SemuBot/semubot-electronics/Kaur-thesis-2025-servo-arm/README.md

# Kaur-thesis-2025-servo-arm
Each separate project folder contains a corresponding readme.
<br>
## Python UI
Instructions and code found in folder ```Servo-Controller-Python-UI```.<br>
Link to original repository: https://github.com/martinkaur/Servo-controller-python-lib.git
<br>
## Controller board firmware
Instructions and code found in folder ```Servo-Controller-Firmware```.<br>
Link to original repository: https://github.com/martinkaur/Servo-Arm-Driver.git
<br>
## Controller board Altium Designer project files
Files found in folder ```Servo-Controller-Altium-Designer-Project-Files```.<br>
Link to original repository: https://github.com/martinkaur/Servo-Arm-Controller-Design.git
