SemuBot/semubot-electronics/servo-arm/pdf/signal-and-supply.pdf

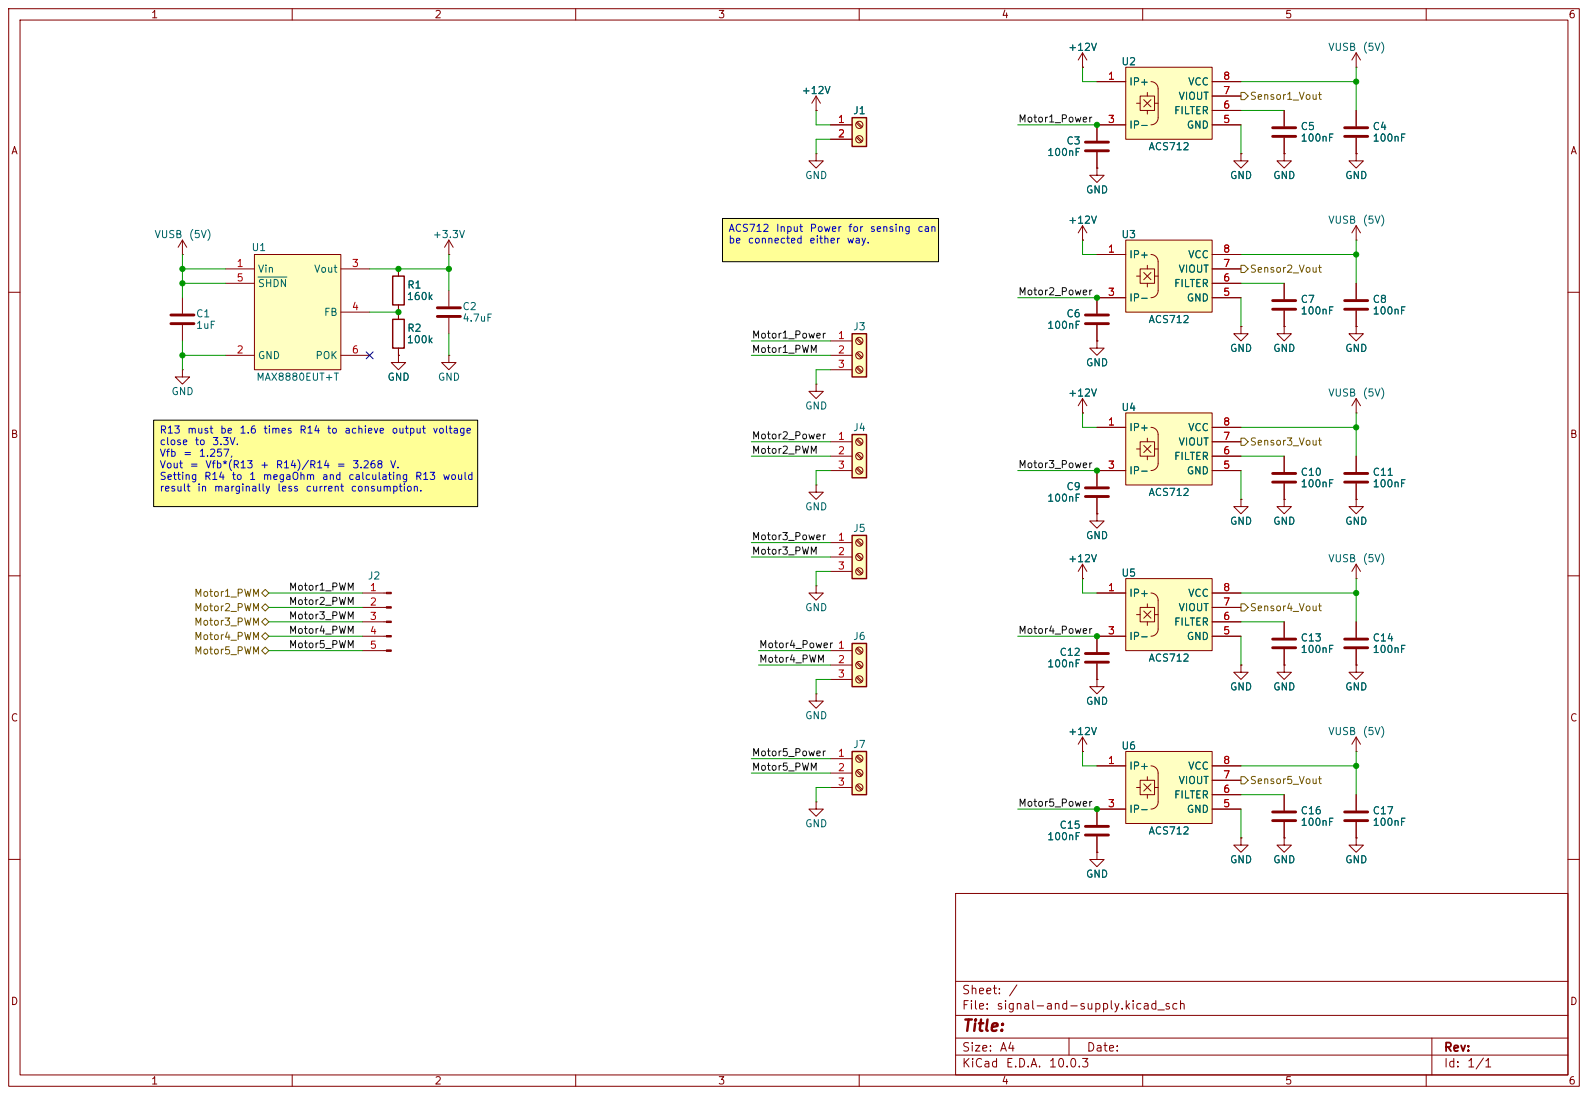
[picture p1: page 1]

be connected either way. +12V

close to 3.3V. Vfb = 1.257, Vout = Vfb*(R13 + R14)/R14 = 3.268 V. Setting R14 to 1 megaOhm and calculating R13 would

Sheet: /
File: signal-and-supply.kicad_sch
Title:

Size: A4 | Rev:
KiCad E.D.A. 10.0.3 | Id: 1/1
