SemuBot/semubot-electronics/(list of files, drawings)

Other design files:
Kaur-thesis-2025-servo-arm/Servo-Controller-Altium-Designer-Project-Files/Arm_controller.PcbDoc
Kaur-thesis-2025-servo-arm/Servo-Controller-Altium-Designer-Project-Files/MCU.SchDoc
Kaur-thesis-2025-servo-arm/Servo-Controller-Altium-Designer-Project-Files/Servo_arm_controller.PrjPcb
Kaur-thesis-2025-servo-arm/Servo-Controller-Altium-Designer-Project-Files/Signal_and_supply.SchDoc
powerboard/HotSwap.SchDoc
powerboard/PCB_S.PcbDoc
powerboard/VoltageDivision.SchDoc
