SemuBot/semubot-electronics/SemuBot_WheelBase/Wheelbase/Wheelbase.kicad_pcb

## KiCad design SemuBot_WheelBase/Wheelbase/Wheelbase.kicad_pcb (2026-09-03)

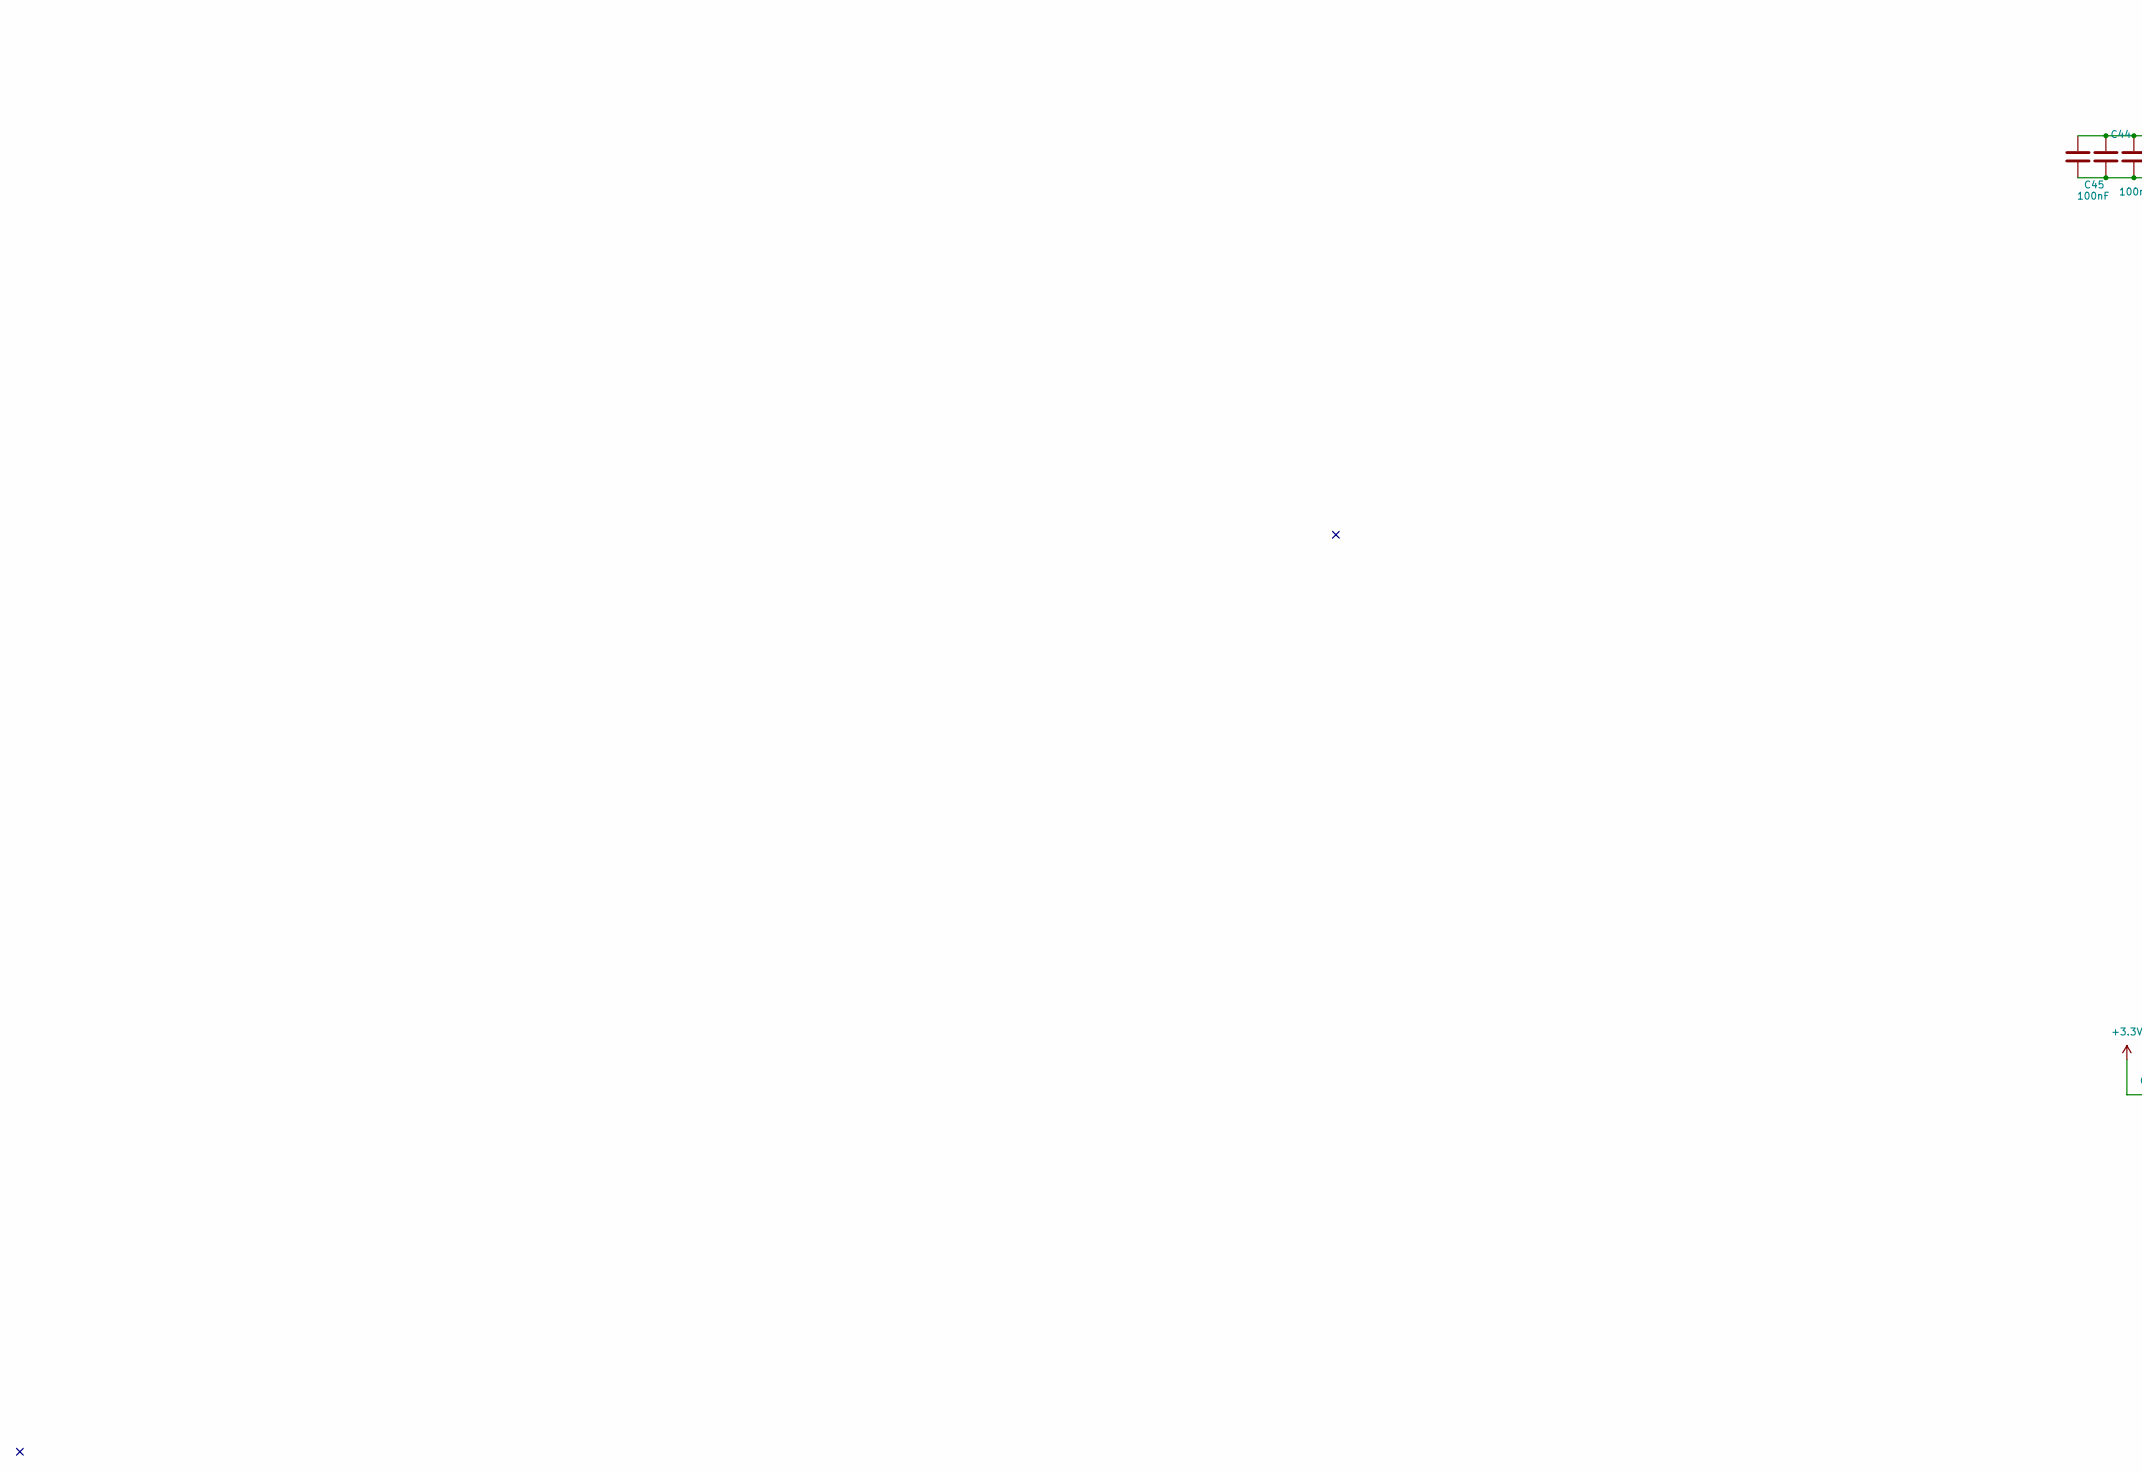
[picture p2: schematic Wheelbase.kicad_sch, part in row 1, column 1]

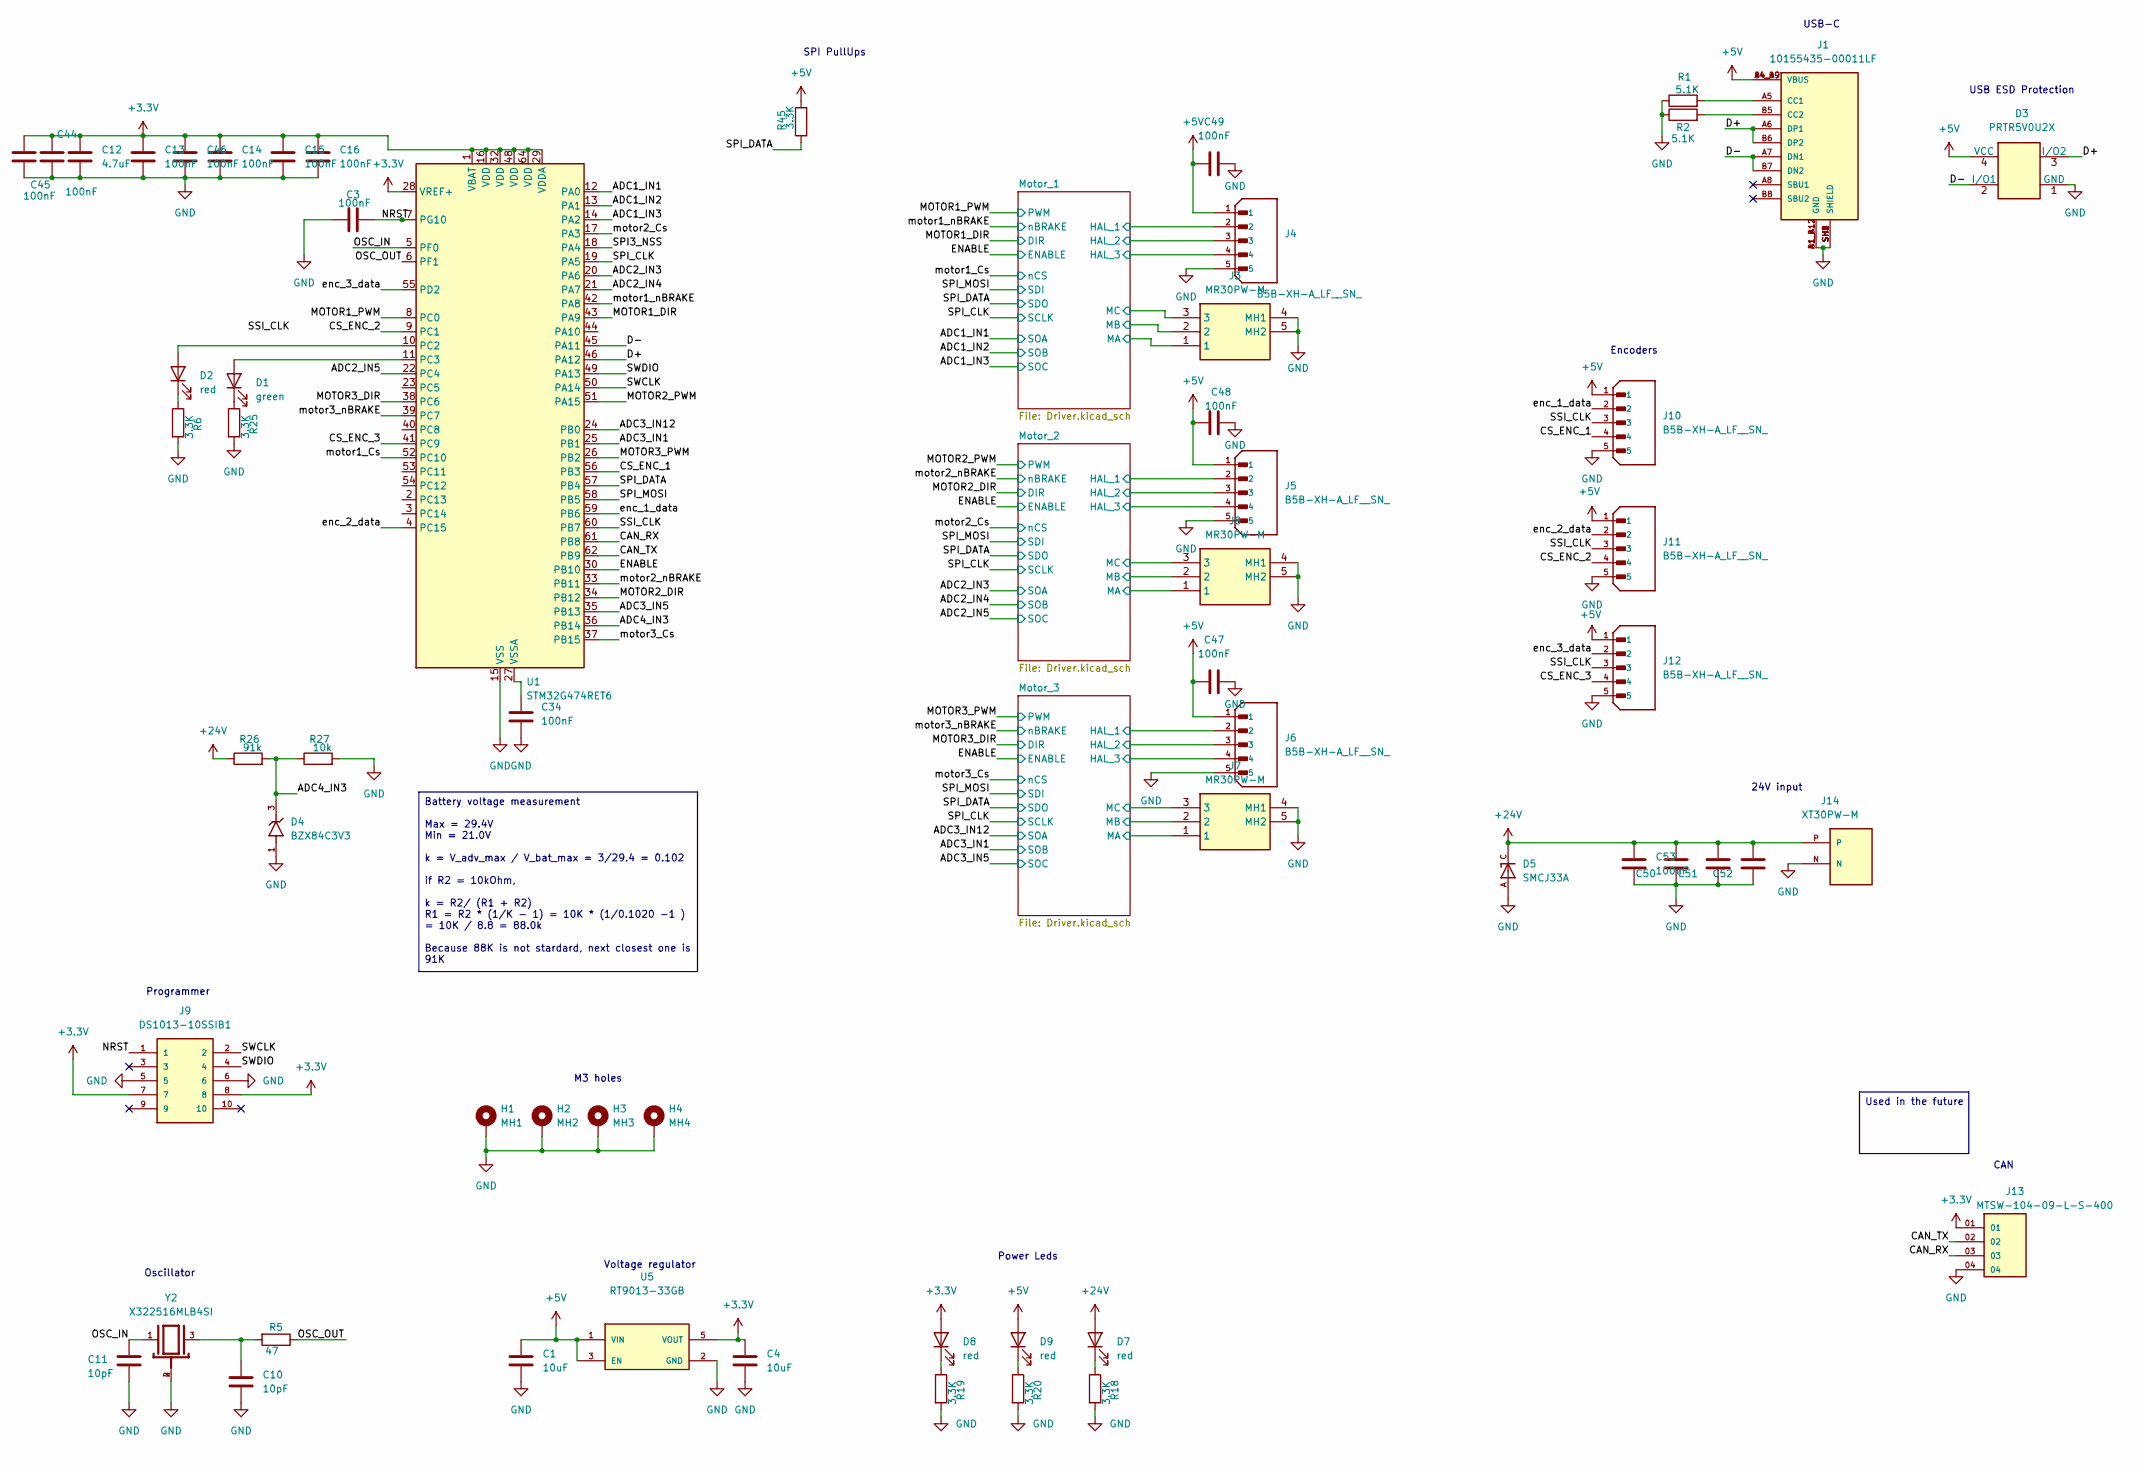
[picture p3: schematic Wheelbase.kicad_sch, part in row 1, column 2]

Parts:
C1, C4: 10uF; C_0805_2012Metric_Pad1.18x1.45mm_HandSolder
C3, C13, C14, C15, C16, C34, C44, C45, C46, C47, C48, C49, C53: 100nF; C_0603_1608Metric_Pad1.08x0.95mm_HandSolder
C10, C11: 10pF; C_0603_1608Metric_Pad1.08x0.95mm_HandSolder
C12: 4.7uF; C_0603_1608Metric_Pad1.08x0.95mm_HandSolder
C50, C51, C52: 470uF 5mm 63V Polymer; CP_Radial_D10.0mm_P5.00mm
D1: green; LED_0603_1608Metric_Pad1.05x0.95mm_HandSolder
D2, D7, D8, D9: red; LED_0603_1608Metric_Pad1.05x0.95mm_HandSolder
D3: PRTR5V0U2X; SOT-143
D4: BZX84C3V3; SOT95P240X115-3N; PARTREV 2025-02-06
D5: SMCJ33A; DIOM6859X262N; PARTREV R2102
H1: MH1; MountingHole_3.2mm_M3_Pad_Via
H2: MH2; MountingHole_3.2mm_M3_Pad_Via
H3: MH3; MountingHole_3.2mm_M3_Pad_Via
H4: MH4; MountingHole_3.2mm_M3_Pad_Via
J1: 10155435-00011LF; AMPHENOL_10155435-00011LF; PARTREV C
J3, J7, J8: MR30PW-M; MR30PWM; Manufacturer_Part_Number MR30PW-M
J4, J5, J6, J10, J11, J12: B5B-XH-A_LF__SN_; JST_B5B-XH-A_LF__SN_; PARTREV 7/4/21
J9: DS1013-10SSIB1; CONNFLY_DS1013-10SSIB1; PARTREV G
J13: MTSW-104-09-L-S-400; SAMTEC_MTSW-104-09-L-S-400; PARTREV R
J14: XT30PW-M; AMASS_XT30PW-M; PARTREV 1.2
R1, R2: 5.1K; R_0603_1608Metric_Pad0.98x0.95mm_HandSolder
R5: 47; R_0603_1608Metric_Pad0.98x0.95mm_HandSolder
R6, R18, R19, R20, R25, R45: 3.3K; R_0603_1608Metric_Pad0.98x0.95mm_HandSolder
R26: 91k; R_0603_1608Metric_Pad0.98x0.95mm_HandSolder
R27: 10k; R_0603_1608Metric_Pad0.98x0.95mm_HandSolder
U1: STM32G474RET6; LQFP-64_10x10mm_P0.5mm
U5: RT9013-33GB; SOT94P279X129-5N; PARTREV Aprill 2011
Y2: X322516MLB4SI; OSC_X322516MLB4SI; PARTREV N/A

Connections:
+3.3V: C4.2, C12.1, C13.1, C14.1, C15.1, C16.1, C44.1, C45.1, C46.1, D8.2 (A), J9.7, J9.8, J13.01, U1.1 (VBAT), U1.16 (VDD), U1.28 (VREF+), U1.29 (VDDA), U1.32 (VDD), U1.48 (VDD), U1.64 (VDD), U5.5 (VOUT); also elsewhere on the board
+5V: C1.2, C47.1, C48.1, C49.1, D3.4 (VCC), D9.2 (A), J1.A4_B9 (VBUS), J1.B4_A9 (VBUS), J4.1, J5.1, J6.1, J10.1, J11.1, J12.1, R45.2, U5.1 (VIN), U5.3 (EN); also elsewhere on the board
+24V: C50.2, C51.2, C52.2, C53.1, D5.C, D7.2 (A), J14.P, R26.1; also elsewhere on the board
/ADC1_IN1: U1.12 (PA0); also elsewhere on the board
/ADC1_IN2: U1.13 (PA1); also elsewhere on the board
/ADC1_IN3: U1.14 (PA2); also elsewhere on the board
/ADC2_IN3: U1.20 (PA6); also elsewhere on the board
/ADC2_IN4: U1.21 (PA7); also elsewhere on the board
/ADC2_IN5: U1.22 (PC4); also elsewhere on the board
/ADC3_IN1: U1.25 (PB1); also elsewhere on the board
/ADC3_IN5: U1.35 (PB13); also elsewhere on the board
/ADC3_IN12: U1.24 (PB0); also elsewhere on the board
/ADC4_IN3: D4.3, R26.2, R27.1, U1.36 (PB14)
/CAN_RX: J13.03, U1.61 (PB8)
/CAN_TX: J13.02, U1.62 (PB9)
/CS_ENC_1: J10.4, U1.56 (PB3)
/CS_ENC_2: J11.4, U1.9 (PC1)
/CS_ENC_3: J12.4, U1.41 (PC9)
/D+: D3.3 (I/O2), J1.A6 (DP1), J1.B6 (DP2), U1.46 (PA12)
/D-: D3.2 (I/O1), J1.A7 (DN1), J1.B7 (DN2), U1.45 (PA11)
/ENABLE: U1.30 (PB10); also elsewhere on the board
/MOTOR1_DIR: U1.43 (PA9); also elsewhere on the board
/MOTOR1_PWM: U1.8 (PC0); also elsewhere on the board
/MOTOR2_DIR: U1.34 (PB12); also elsewhere on the board
/MOTOR2_PWM: U1.51 (PA15); also elsewhere on the board
/MOTOR3_DIR: U1.38 (PC6); also elsewhere on the board
/MOTOR3_PWM: U1.26 (PB2); also elsewhere on the board
/Motor_1/HAL_1: J4.2; also elsewhere on the board
/Motor_1/HAL_2: J4.3; also elsewhere on the board
/Motor_1/HAL_3: J4.4; also elsewhere on the board
/Motor_1/SHA: J3.1; also elsewhere on the board
/Motor_1/SHB: J3.2; also elsewhere on the board
/Motor_1/SHC: J3.3; also elsewhere on the board
/Motor_2/HAL_1: J5.2; also elsewhere on the board
/Motor_2/HAL_2: J5.3; also elsewhere on the board
/Motor_2/HAL_3: J5.4; also elsewhere on the board
/Motor_2/SHA: J8.1; also elsewhere on the board
/Motor_2/SHB: J8.2; also elsewhere on the board
/Motor_2/SHC: J8.3; also elsewhere on the board
/Motor_3/HAL_1: J6.2; also elsewhere on the board
/Motor_3/HAL_2: J6.3; also elsewhere on the board
/Motor_3/HAL_3: J6.4; also elsewhere on the board
/Motor_3/SHA: J7.1; also elsewhere on the board
/Motor_3/SHB: J7.2; also elsewhere on the board
/Motor_3/SHC: J7.3; also elsewhere on the board
/NRST: C3.2, J9.1, U1.7 (PG10)
/OSC_IN: C11.1, U1.5 (PF0), Y2.1
/OSC_OUT: R5.1, U1.6 (PF1)
/SPI3_NSS: U1.18 (PA4)
/SPI_CLK: U1.19 (PA5); also elsewhere on the board
/SPI_DATA: R45.1, U1.57 (PB4); also elsewhere on the board
/SPI_MOSI: U1.58 (PB5); also elsewhere on the board
/SSI_CLK: J10.3, J11.3, J12.3, U1.60 (PB7)
/SWCLK: J9.2, U1.50 (PA14)
/SWDIO: J9.4, U1.49 (PA13)
/enc_1_data: J10.2, U1.59 (PB6)
/enc_2_data: J11.2, U1.4 (PC15)
/enc_3_data: J12.2, U1.55 (PD2)
/motor1_Cs: U1.52 (PC10); also elsewhere on the board
/motor1_nBRAKE: U1.42 (PA8); also elsewhere on the board
/motor2_Cs: U1.17 (PA3); also elsewhere on the board
/motor2_nBRAKE: U1.33 (PB11); also elsewhere on the board
/motor3_Cs: U1.37 (PB15); also elsewhere on the board
/motor3_nBRAKE: U1.39 (PC7); also elsewhere on the board
GND: C1.1, C3.1, C4.1, C10.1, C11.2, C12.2, C13.2, C14.2, C15.2, C16.2, C34.2, C44.2, C45.2, C46.2, C47.2, C48.2, C49.2, C50.1, C51.1, C52.1, C53.2, D3.1 (GND), D4.1, D5.A, H1.1 (1_1), H2.1 (1_1), H3.1 (1_1), H4.1 (1_1), J1.A1_B12 (GND), J1.B1_A12 (GND), J1.SH1 (SHIELD), J1.SH2 (SHIELD), J1.SH3 (SHIELD), J1.SH4 (SHIELD), J3.4 (MH1), J3.5 (MH2), J4.5, J5.5, J6.5, J7.4 (MH1), J7.5 (MH2), J8.4 (MH1), J8.5 (MH2), J9.5, J9.6, J10.5, J11.5, J12.5, J13.04, J14.N, R1.1, R2.1, R6.2, R18.2, R19.2, R20.2, R25.2, R27.2, U1.15 (VSS), U1.31 (VSS), U1.47 (VSS), U1.63 (VSS), U5.2 (GND), Y2.2, Y2.4; also elsewhere on the board
unnamed: C10.2, R5.2, Y2.3
unnamed: D1.2 (A), U1.11 (PC3)
unnamed: D1.1 (K), R25.1
unnamed: D2.2 (A), U1.10 (PC2)
unnamed: D2.1 (K), R6.1
unnamed: D7.1 (K), R18.1
unnamed: D8.1 (K), R19.1
unnamed: D9.1 (K), R20.1
unnamed: J1.A5 (CC1), R1.2
unnamed: J1.B5 (CC2), R2.2
unnamed: C34.1, U1.27 (VSSA)

Notes on the sheet:
24V input
Encoders
M3 holes
Oscillator
USB-C
USB ESD Protection
CAN
SPI PullUps
Power Leds
Programmer
Voltage regulator
Used in the future
Battery voltage measurement Max = 29.4V Min = 21.0V k = V_adv_max / V_bat_max = 3/29.4 = 0.102 if R2 = 10kOhm, k = R2/ (R1 + R2) R1 = R2 * (1/K - 1) = 10K * (1/0.1020 -1 ) = 10K / 8.8 = 88.0k Because 88K is not stardard, next closest one is 91K

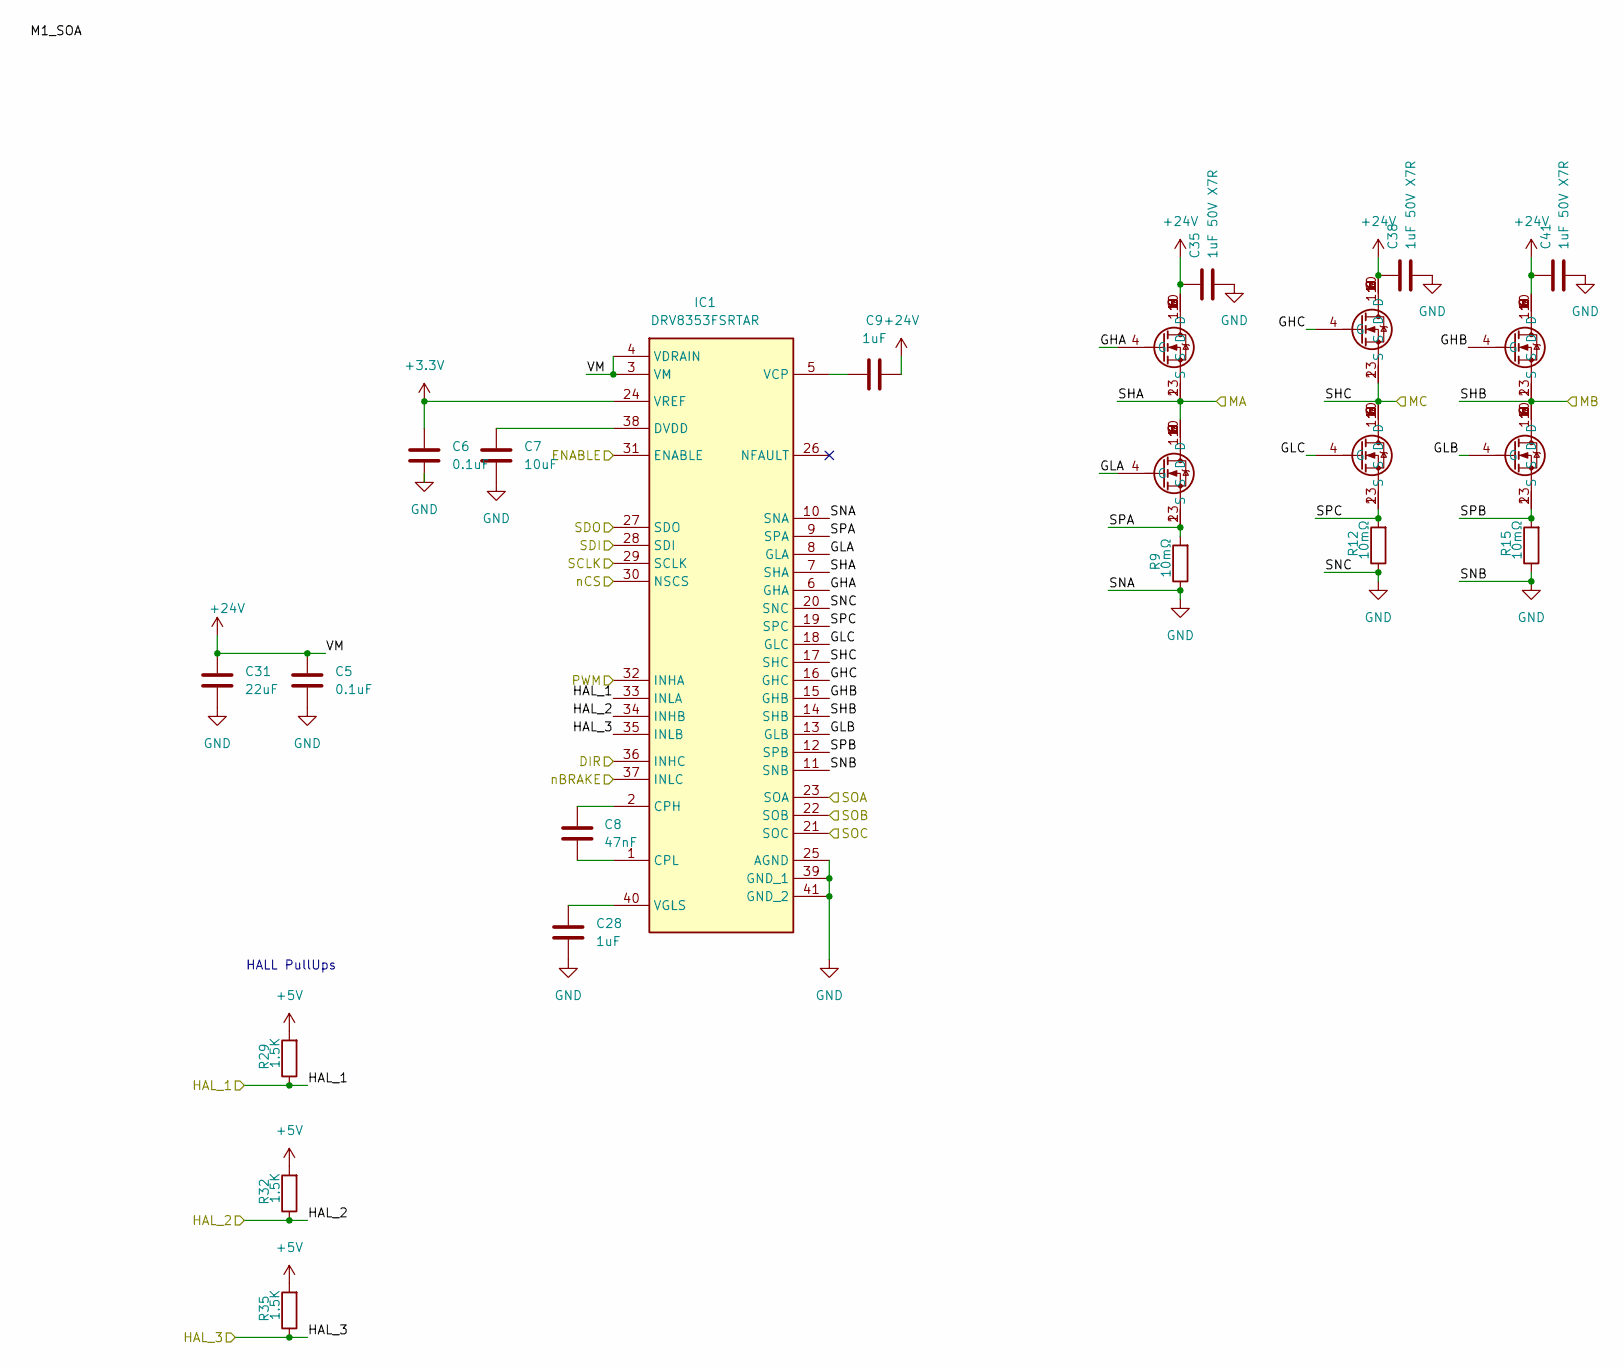
[picture p4: schematic Driver.kicad_sch]

Parts:
C5, C6: 0.1uF; C_0603_1608Metric_Pad1.08x0.95mm_HandSolder
C7: 10uF; C_0603_1608Metric_Pad1.08x0.95mm_HandSolder
C8: 47nF; C_0603_1608Metric_Pad1.08x0.95mm_HandSolder
C9, C28: 1uF; C_0603_1608Metric_Pad1.08x0.95mm_HandSolder
C31: 22uF; C_0805_2012Metric_Pad1.18x1.45mm_HandSolder
C35, C38, C41: 1uF 50V X7R; C_0805_2012Metric_Pad1.18x1.45mm_HandSolder
IC1: DRV8353FSRTAR; QFN50P600X600X80-41N-D; Mouser Part Number 595-DRV8353FSRTAR
Q1, Q2, Q3, Q5, Q6, Q19: AONR62818; AON7262E; Manufacturer_Part_Number AON7262E
R9, R12, R15: 10mΩ; R_2512_6332Metric_Pad1.40x3.35mm_HandSolder
R29, R32, R35: 1.5K; R_0603_1608Metric_Pad0.98x0.95mm_HandSolder

Connections:
+3.3V: C6.1, IC1.24 (VREF); also elsewhere on the board
+5V: R29.2, R32.2, R35.2; also elsewhere on the board
+24V: C5.1, C9.2, C31.2, C35.1, C38.1, C41.1, IC1.3 (VM), IC1.4 (VDRAIN), Q1.5 (D), Q1.6 (D), Q1.7 (D), Q1.8 (D), Q1.9 (D), Q1.10 (D), Q1.11 (D), Q3.5 (D), Q3.6 (D), Q3.7 (D), Q3.8 (D), Q3.9 (D), Q3.10 (D), Q3.11 (D), Q5.5 (D), Q5.6 (D), Q5.7 (D), Q5.8 (D), Q5.9 (D), Q5.10 (D), Q5.11 (D); also elsewhere on the board
/ADC1_IN1: IC1.23 (SOA); also elsewhere on the board
/ADC1_IN2: IC1.22 (SOB); also elsewhere on the board
/ADC1_IN3: IC1.21 (SOC); also elsewhere on the board
/ENABLE: IC1.31 (ENABLE); also elsewhere on the board
/MOTOR1_DIR: IC1.36 (INHC); also elsewhere on the board
/MOTOR1_PWM: IC1.32 (INHA); also elsewhere on the board
/Motor_1/GHA: IC1.6 (GHA), Q1.4 (G)
/Motor_1/GHB: IC1.15 (GHB), Q3.4 (G)
/Motor_1/GHC: IC1.16 (GHC), Q5.4 (G)
/Motor_1/GLA: IC1.8 (GLA), Q2.4 (G)
/Motor_1/GLB: IC1.13 (GLB), Q19.4 (G)
/Motor_1/GLC: IC1.18 (GLC), Q6.4 (G)
/Motor_1/HAL_1: IC1.33 (INLA), R29.1; also elsewhere on the board
/Motor_1/HAL_2: IC1.34 (INHB), R32.1; also elsewhere on the board
/Motor_1/HAL_3: IC1.35 (INLB), R35.1; also elsewhere on the board
/Motor_1/SHA: IC1.7 (SHA), Q1.1 (S), Q1.2 (S), Q1.3 (S), Q2.5 (D), Q2.6 (D), Q2.7 (D), Q2.8 (D), Q2.9 (D), Q2.10 (D), Q2.11 (D); also elsewhere on the board
/Motor_1/SHB: IC1.14 (SHB), Q3.1 (S), Q3.2 (S), Q3.3 (S), Q19.5 (D), Q19.6 (D), Q19.7 (D), Q19.8 (D), Q19.9 (D), Q19.10 (D), Q19.11 (D); also elsewhere on the board
/Motor_1/SHC: IC1.17 (SHC), Q5.1 (S), Q5.2 (S), Q5.3 (S), Q6.5 (D), Q6.6 (D), Q6.7 (D), Q6.8 (D), Q6.9 (D), Q6.10 (D), Q6.11 (D); also elsewhere on the board
/Motor_1/SPA: IC1.9 (SPA), Q2.1 (S), Q2.2 (S), Q2.3 (S), R9.2
/Motor_1/SPB: IC1.12 (SPB), Q19.1 (S), Q19.2 (S), Q19.3 (S), R15.2
/Motor_1/SPC: IC1.19 (SPC), Q6.1 (S), Q6.2 (S), Q6.3 (S), R12.2
/SPI_CLK: IC1.29 (SCLK); also elsewhere on the board
/SPI_DATA: IC1.27 (SDO); also elsewhere on the board
/SPI_MOSI: IC1.28 (SDI); also elsewhere on the board
/motor1_Cs: IC1.30 (NSCS); also elsewhere on the board
/motor1_nBRAKE: IC1.37 (INLC); also elsewhere on the board
GND: C5.2, C6.2, C7.2, C28.1, C31.1, C35.2, C38.2, C41.2, IC1.10 (SNA), IC1.11 (SNB), IC1.20 (SNC), IC1.25 (AGND), IC1.39 (GND_1), IC1.41 (GND_2), R9.1, R12.1, R15.1; also elsewhere on the board
unnamed: C8.1, IC1.2 (CPH)
unnamed: C8.2, IC1.1 (CPL)
unnamed: C7.1, IC1.38 (DVDD)
unnamed: C9.1, IC1.5 (VCP)
unnamed: C28.2, IC1.40 (VGLS)

Parts of its further copies:
C17, C18, C23, C24: 0.1uF; C_0603_1608Metric_Pad1.08x0.95mm_HandSolder
C19, C25: 10uF; C_0603_1608Metric_Pad1.08x0.95mm_HandSolder
C20, C26: 47nF; C_0603_1608Metric_Pad1.08x0.95mm_HandSolder
C21, C27, C29, C30: 1uF; C_0603_1608Metric_Pad1.08x0.95mm_HandSolder
C32, C33: 22uF; C_0805_2012Metric_Pad1.18x1.45mm_HandSolder
C36, C37, C39, C40, C42, C43: 1uF 50V X7R; C_0805_2012Metric_Pad1.18x1.45mm_HandSolder
IC2, IC3: DRV8353FSRTAR; QFN50P600X600X80-41N-D; Mouser Part Number 595-DRV8353FSRTAR
Q4, Q7, Q8, Q9, Q10, Q11, Q12, Q13, Q14, Q15, Q20, Q21: AONR62818; AON7262E; Manufacturer_Part_Number AON7262E
R10, R11, R13, R14, R16, R17: 10mΩ; R_2512_6332Metric_Pad1.40x3.35mm_HandSolder
R30, R31, R33, R34, R37, R38: 1.5K; R_0603_1608Metric_Pad0.98x0.95mm_HandSolder

Connections of its further copies:
+3.3V: C18.1, C24.1, IC2.24 (VREF), IC3.24 (VREF); also elsewhere on the board
+5V: R30.2, R31.2, R33.2, R34.2, R37.2, R38.2; also elsewhere on the board
+24V: C17.1, C21.2, C23.1, C27.2, C32.2, C33.2, C36.1, C37.1, C39.1, C40.1, C42.1, C43.1, IC2.3 (VM), IC2.4 (VDRAIN), IC3.3 (VM), IC3.4 (VDRAIN), Q4.5 (D), Q4.6 (D), Q4.7 (D), Q4.8 (D), Q4.9 (D), Q4.10 (D), Q4.11 (D), Q7.5 (D), Q7.6 (D), Q7.7 (D), Q7.8 (D), Q7.9 (D), Q7.10 (D), Q7.11 (D), Q9.5 (D), Q9.6 (D), Q9.7 (D), Q9.8 (D), Q9.9 (D), Q9.10 (D), Q9.11 (D), Q11.5 (D), Q11.6 (D), Q11.7 (D), Q11.8 (D), Q11.9 (D), Q11.10 (D), Q11.11 (D), Q13.5 (D), Q13.6 (D), Q13.7 (D), Q13.8 (D), Q13.9 (D), Q13.10 (D), Q13.11 (D), Q15.5 (D), Q15.6 (D), Q15.7 (D), Q15.8 (D), Q15.9 (D), Q15.10 (D), Q15.11 (D); also elsewhere on the board
/ADC2_IN3: IC2.23 (SOA); also elsewhere on the board
/ADC2_IN4: IC2.22 (SOB); also elsewhere on the board
/ADC2_IN5: IC2.21 (SOC); also elsewhere on the board
/ADC3_IN1: IC3.22 (SOB); also elsewhere on the board
/ADC3_IN5: IC3.21 (SOC); also elsewhere on the board
/ADC3_IN12: IC3.23 (SOA); also elsewhere on the board
/ENABLE: IC2.31 (ENABLE), IC3.31 (ENABLE); also elsewhere on the board
/MOTOR2_DIR: IC2.36 (INHC); also elsewhere on the board
/MOTOR2_PWM: IC2.32 (INHA); also elsewhere on the board
/MOTOR3_DIR: IC3.36 (INHC); also elsewhere on the board
/MOTOR3_PWM: IC3.32 (INHA); also elsewhere on the board
/Motor_2/GHA: IC2.6 (GHA), Q7.4 (G)
/Motor_2/GHB: IC2.15 (GHB), Q4.4 (G)
/Motor_2/GHC: IC2.16 (GHC), Q11.4 (G)
/Motor_2/GLA: IC2.8 (GLA), Q8.4 (G)
/Motor_2/GLB: IC2.13 (GLB), Q20.4 (G)
/Motor_2/GLC: IC2.18 (GLC), Q10.4 (G)
/Motor_2/HAL_1: IC2.33 (INLA), R30.1; also elsewhere on the board
/Motor_2/HAL_2: IC2.34 (INHB), R33.1; also elsewhere on the board
/Motor_2/HAL_3: IC2.35 (INLB), R37.1; also elsewhere on the board
/Motor_2/SHA: IC2.7 (SHA), Q7.1 (S), Q7.2 (S), Q7.3 (S), Q8.5 (D), Q8.6 (D), Q8.7 (D), Q8.8 (D), Q8.9 (D), Q8.10 (D), Q8.11 (D); also elsewhere on the board
/Motor_2/SHB: IC2.14 (SHB), Q4.1 (S), Q4.2 (S), Q4.3 (S), Q20.5 (D), Q20.6 (D), Q20.7 (D), Q20.8 (D), Q20.9 (D), Q20.10 (D), Q20.11 (D); also elsewhere on the board
/Motor_2/SHC: IC2.17 (SHC), Q10.5 (D), Q10.6 (D), Q10.7 (D), Q10.8 (D), Q10.9 (D), Q10.10 (D), Q10.11 (D), Q11.1 (S), Q11.2 (S), Q11.3 (S); also elsewhere on the board
/Motor_2/SPA: IC2.9 (SPA), Q8.1 (S), Q8.2 (S), Q8.3 (S), R10.2
/Motor_2/SPB: IC2.12 (SPB), Q20.1 (S), Q20.2 (S), Q20.3 (S), R16.2
/Motor_2/SPC: IC2.19 (SPC), Q10.1 (S), Q10.2 (S), Q10.3 (S), R13.2
/Motor_3/GHA: IC3.6 (GHA), Q13.4 (G)
/Motor_3/GHB: IC3.15 (GHB), Q9.4 (G)
/Motor_3/GHC: IC3.16 (GHC), Q15.4 (G)
/Motor_3/GLA: IC3.8 (GLA), Q14.4 (G)
/Motor_3/GLB: IC3.13 (GLB), Q21.4 (G)
/Motor_3/GLC: IC3.18 (GLC), Q12.4 (G)
/Motor_3/HAL_1: IC3.33 (INLA), R31.1; also elsewhere on the board
/Motor_3/HAL_2: IC3.34 (INHB), R34.1; also elsewhere on the board
/Motor_3/HAL_3: IC3.35 (INLB), R38.1; also elsewhere on the board
/Motor_3/SHA: IC3.7 (SHA), Q13.1 (S), Q13.2 (S), Q13.3 (S), Q14.5 (D), Q14.6 (D), Q14.7 (D), Q14.8 (D), Q14.9 (D), Q14.10 (D), Q14.11 (D); also elsewhere on the board
/Motor_3/SHB: IC3.14 (SHB), Q9.1 (S), Q9.2 (S), Q9.3 (S), Q21.5 (D), Q21.6 (D), Q21.7 (D), Q21.8 (D), Q21.9 (D), Q21.10 (D), Q21.11 (D); also elsewhere on the board
/Motor_3/SHC: IC3.17 (SHC), Q12.5 (D), Q12.6 (D), Q12.7 (D), Q12.8 (D), Q12.9 (D), Q12.10 (D), Q12.11 (D), Q15.1 (S), Q15.2 (S), Q15.3 (S); also elsewhere on the board
/Motor_3/SPA: IC3.9 (SPA), Q14.1 (S), Q14.2 (S), Q14.3 (S), R11.2
/Motor_3/SPB: IC3.12 (SPB), Q21.1 (S), Q21.2 (S), Q21.3 (S), R17.2
/Motor_3/SPC: IC3.19 (SPC), Q12.1 (S), Q12.2 (S), Q12.3 (S), R14.2
/SPI_CLK: IC2.29 (SCLK), IC3.29 (SCLK); also elsewhere on the board
/SPI_DATA: IC2.27 (SDO), IC3.27 (SDO); also elsewhere on the board
/SPI_MOSI: IC2.28 (SDI), IC3.28 (SDI); also elsewhere on the board
/motor2_Cs: IC2.30 (NSCS); also elsewhere on the board
/motor2_nBRAKE: IC2.37 (INLC); also elsewhere on the board
/motor3_Cs: IC3.30 (NSCS); also elsewhere on the board
/motor3_nBRAKE: IC3.37 (INLC); also elsewhere on the board
GND: C17.2, C18.2, C19.2, C23.2, C24.2, C25.2, C29.1, C30.1, C32.1, C33.1, C36.2, C37.2, C39.2, C40.2, C42.2, C43.2, IC2.10 (SNA), IC2.11 (SNB), IC2.20 (SNC), IC2.25 (AGND), IC2.39 (GND_1), IC2.41 (GND_2), IC3.10 (SNA), IC3.11 (SNB), IC3.20 (SNC), IC3.25 (AGND), IC3.39 (GND_1), IC3.41 (GND_2), R10.1, R11.1, R13.1, R14.1, R16.1, R17.1; also elsewhere on the board
unnamed: C20.1, IC2.2 (CPH)
unnamed: C20.2, IC2.1 (CPL)
unnamed: C19.1, IC2.38 (DVDD)
unnamed: C21.1, IC2.5 (VCP)
unnamed: C29.2, IC2.40 (VGLS)
unnamed: C26.1, IC3.2 (CPH)
unnamed: C26.2, IC3.1 (CPL)
unnamed: C25.1, IC3.38 (DVDD)
unnamed: C27.1, IC3.5 (VCP)
unnamed: C30.2, IC3.40 (VGLS)

Notes on the sheet:
HALL PullUps

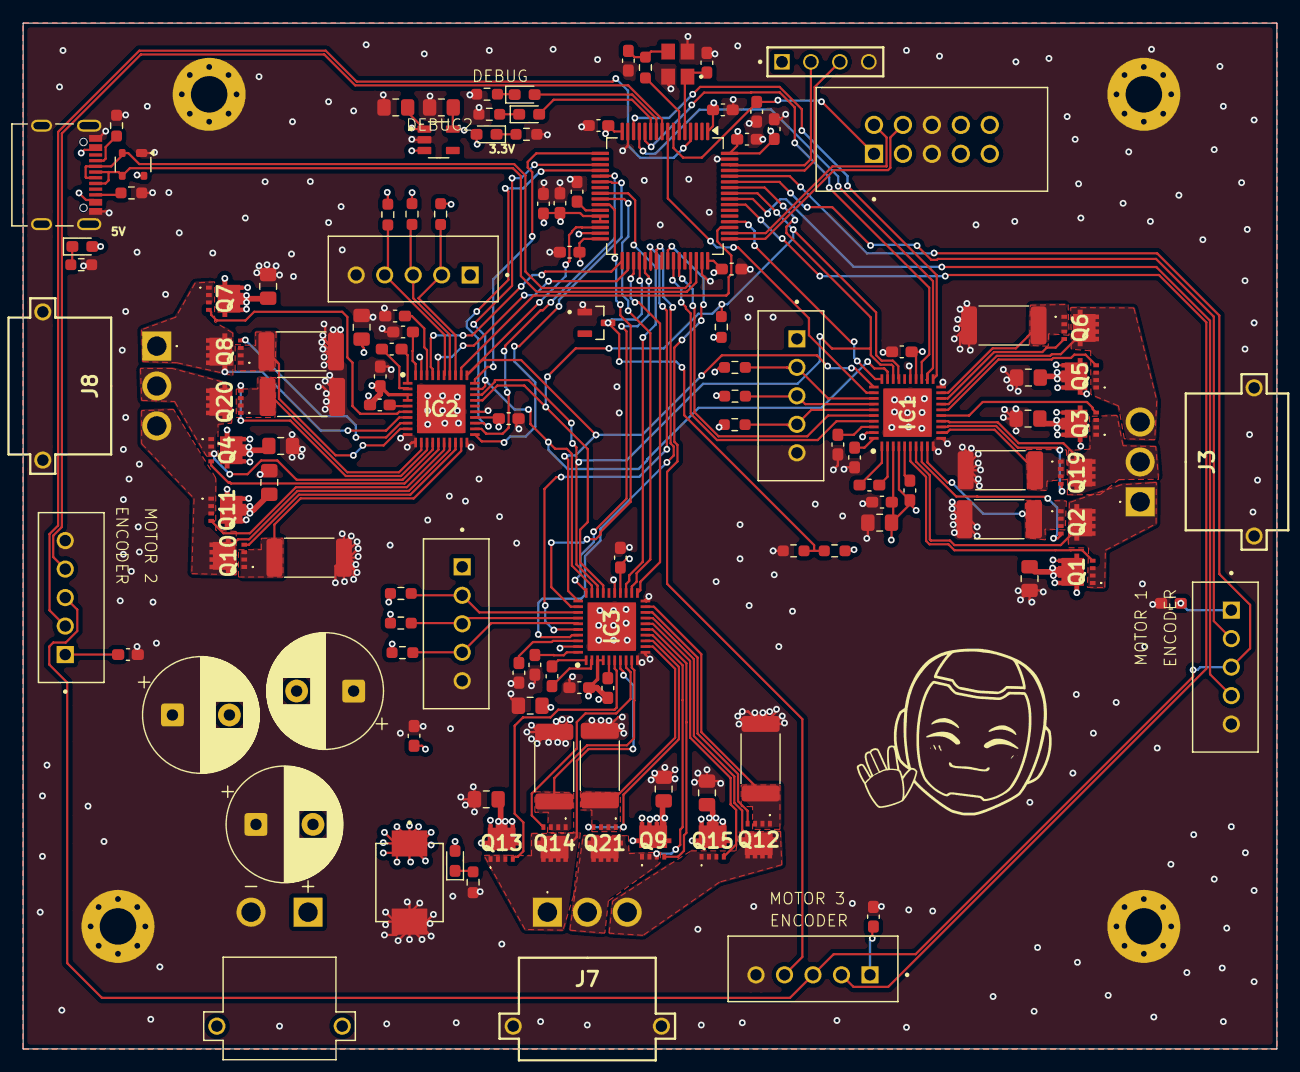
[picture p5: board Wheelbase.kicad_pcb from above]

Board: 4 copper layers, 110.0 x 90.0 mm, 129 parts (0 on the bottom side), 117 nets.
