SemuBot/semubot-electronics/powerboard/hot-swap.kicad_sch

## KiCad design powerboard/hot-swap.kicad_sch (2026-10-29)

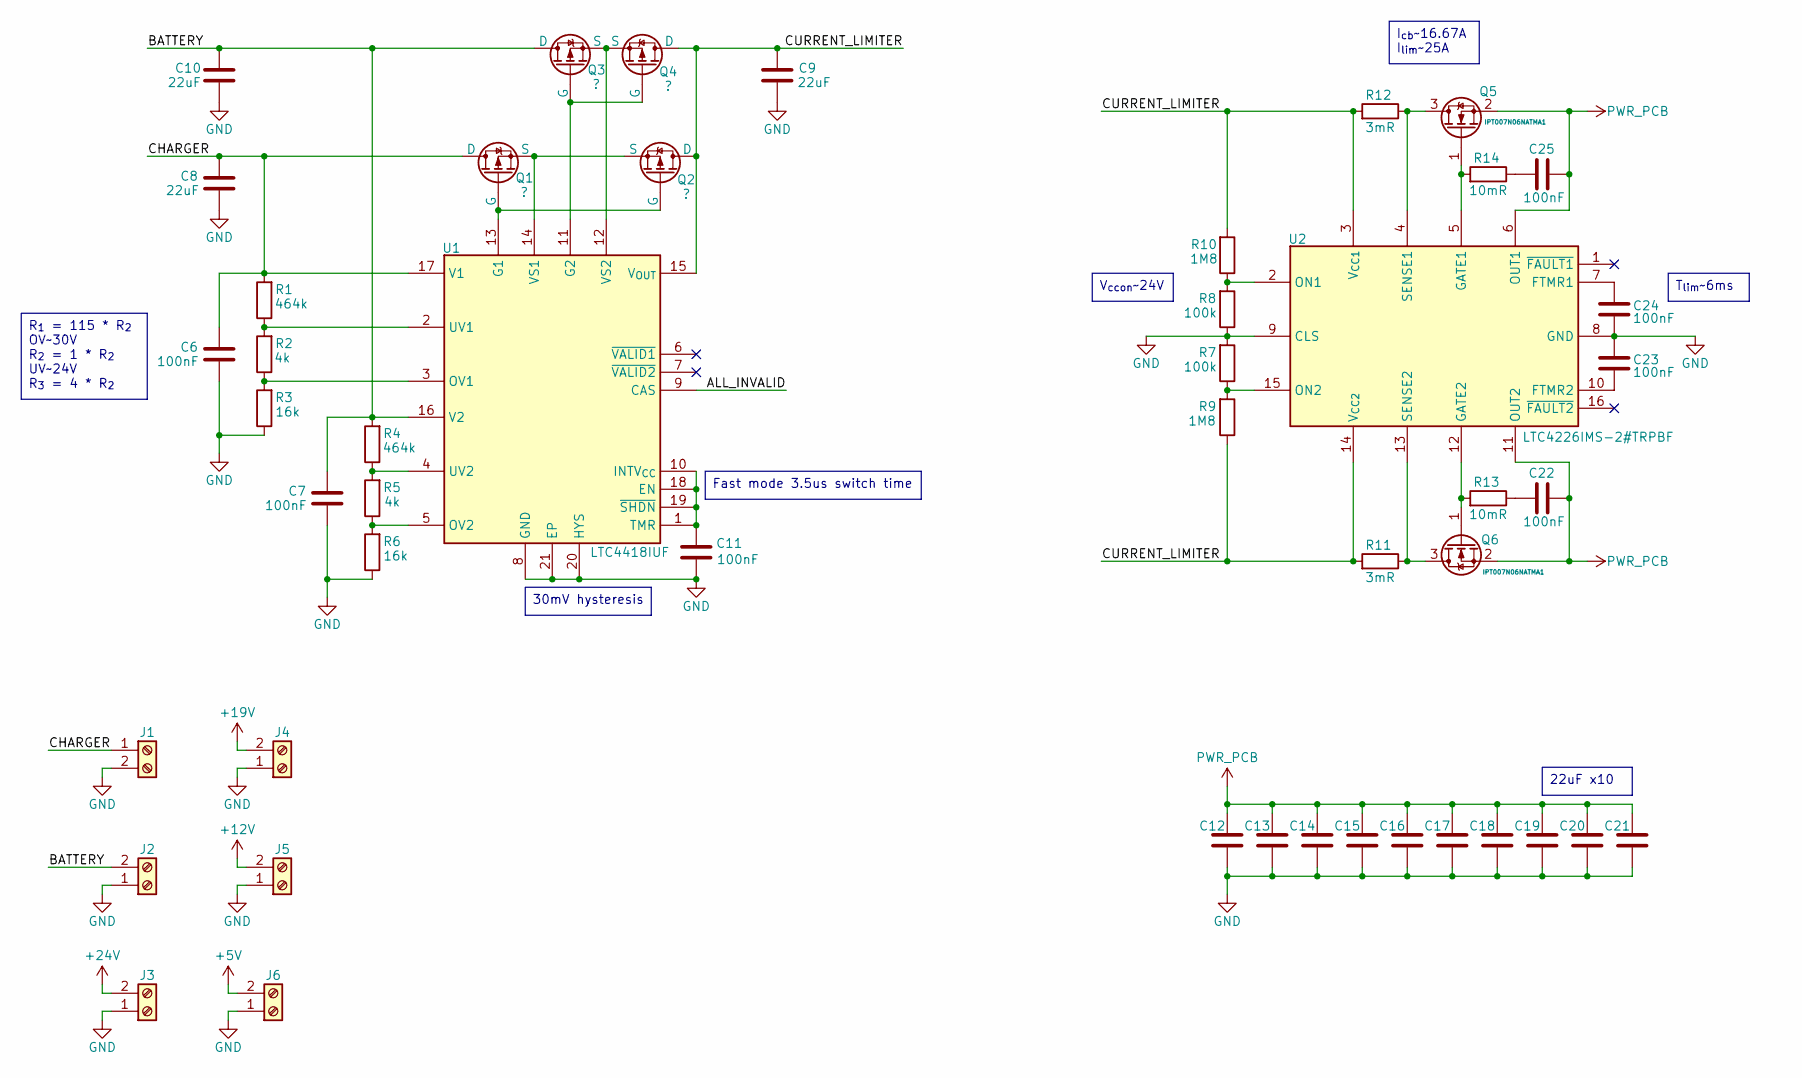
[picture p6: schematic hot-swap.kicad_sch]

Parts:
C6, C7, C11, C22, C23, C24, C25: 100nF; C_0603_1608Metric
C8, C9, C10, C12, C13, C14, C15, C16, C17, C18, C19, C20, C21: 22uF; C_2220_5750Metric
J1, J2, J3, J4, J5, J6: Screw_Terminal_01x02
Q1, Q2, Q3, Q4: ?
Q5, Q6: IPT007N06NATMA1; Infineon_PG-HSOF-8-1
R1, R4: 464k; R_0603_1608Metric
R2, R5: 4k; R_0603_1608Metric
R3, R6: 16k; R_0603_1608Metric
R7, R8: 100k; R_0603_1608Metric
R9, R10: 1M8; R_0603_1608Metric
R11, R12: 3mR; R_2512_6332Metric
R13, R14: 10mR; R_2512_6332Metric
U1: LTC4418IUF; QFN-20-1EP_4x4mm_P0.5mm_EP2.5x2.5mm
U2: LTC4226IMS-2#TRPBF

Connections:
+5V: J6.2
+12V: J5.2
+19V: J4.2
+24V: J3.2
ALL_INVALID: U1.9 (CAS)
BATTERY: C7.2, C10.2, J2.2, Q3.1 (D), R4.2, U1.16 (V2)
CHARGER: C6.2, C8.2, J1.1, Q1.1 (D), R1.2, U1.17 (V1)
CURRENT_LIMITER: C9.2, Q2.1 (D), Q4.1 (D), R9.1, R10.2, R11.2, R12.2, U1.15 (V_{OUT}), U2.3 (V_{CC1}), U2.14 (V_{CC2})
GND: C6.1, C7.1, C8.1, C9.1, C10.1, C11.1, C12.1, C13.1, C14.1, C15.1, C16.1, C17.1, C18.1, C19.1, C20.1, C21.1, C23.1, C24.2, J1.2, J2.1, J3.1, J4.1, J5.1, J6.1, R3.1, R6.1, R7.2, R8.1, U1.8 (GND), U1.20 (HYS), U1.21 (EP), U2.8 (GND), U2.9 (CLS)
unnamed: C11.2, U1.1 (TMR), U1.10 (INTV_{CC}), U1.18 (EN), U1.19 (~SHDN)
unnamed: C22.2, R13.1
unnamed: C23.2, U2.10 (FTMR2)
unnamed: C24.1, U2.7 (FTMR1)
unnamed: C25.2, R14.1
unnamed: Q1.2 (G), Q2.2 (G), U1.13 (G1)
unnamed: Q1.3 (S), Q2.3 (S), U1.14 (VS1)
unnamed: Q3.2 (G), Q4.2 (G), U1.11 (G2)
unnamed: Q3.3 (S), Q4.3 (S), U1.12 (VS2)
unnamed: Q5.1 (G), R14.2, U2.5 (GATE1)
unnamed: Q5.3 (D), R12.1, U2.4 (SENSE1)
unnamed: Q6.1 (G), R13.2, U2.12 (GATE2)
unnamed: Q6.3 (D), R11.1, U2.13 (SENSE2)
unnamed: R1.1, R2.2, U1.2 (UV1)
unnamed: R2.1, R3.2, U1.3 (OV1)
unnamed: R4.1, R5.2, U1.4 (UV2)
unnamed: R5.1, R6.2, U1.5 (OV2)
unnamed: R7.1, R9.2, U2.15 (ON2)
unnamed: R8.2, R10.1, U2.2 (ON1)
PWR_PCB: C12.2, C13.2, C14.2, C15.2, C16.2, C17.2, C18.2, C19.2, C20.2, C21.2, C22.1, C25.1, Q5.2 (S), Q6.2 (S), U2.6 (OUT1), U2.11 (OUT2)

Notes on the sheet:
Fast mode 3.5us switch time
22uF x10
30mV hysteresis
R_{1} = 115 * R_{2} OV~30V R_{2} = 1 * R_{2} UV~24V R_{3} = 4 * R_{2}
I_{cb}~16.67A I_{lim}~25A
V_{ccon}~24V
T_{lim}~6ms
