SemuBot/semubot-electronics/servo-arm/mcu.kicad_sch

## KiCad design servo-arm/mcu.kicad_sch (2026-10-29)

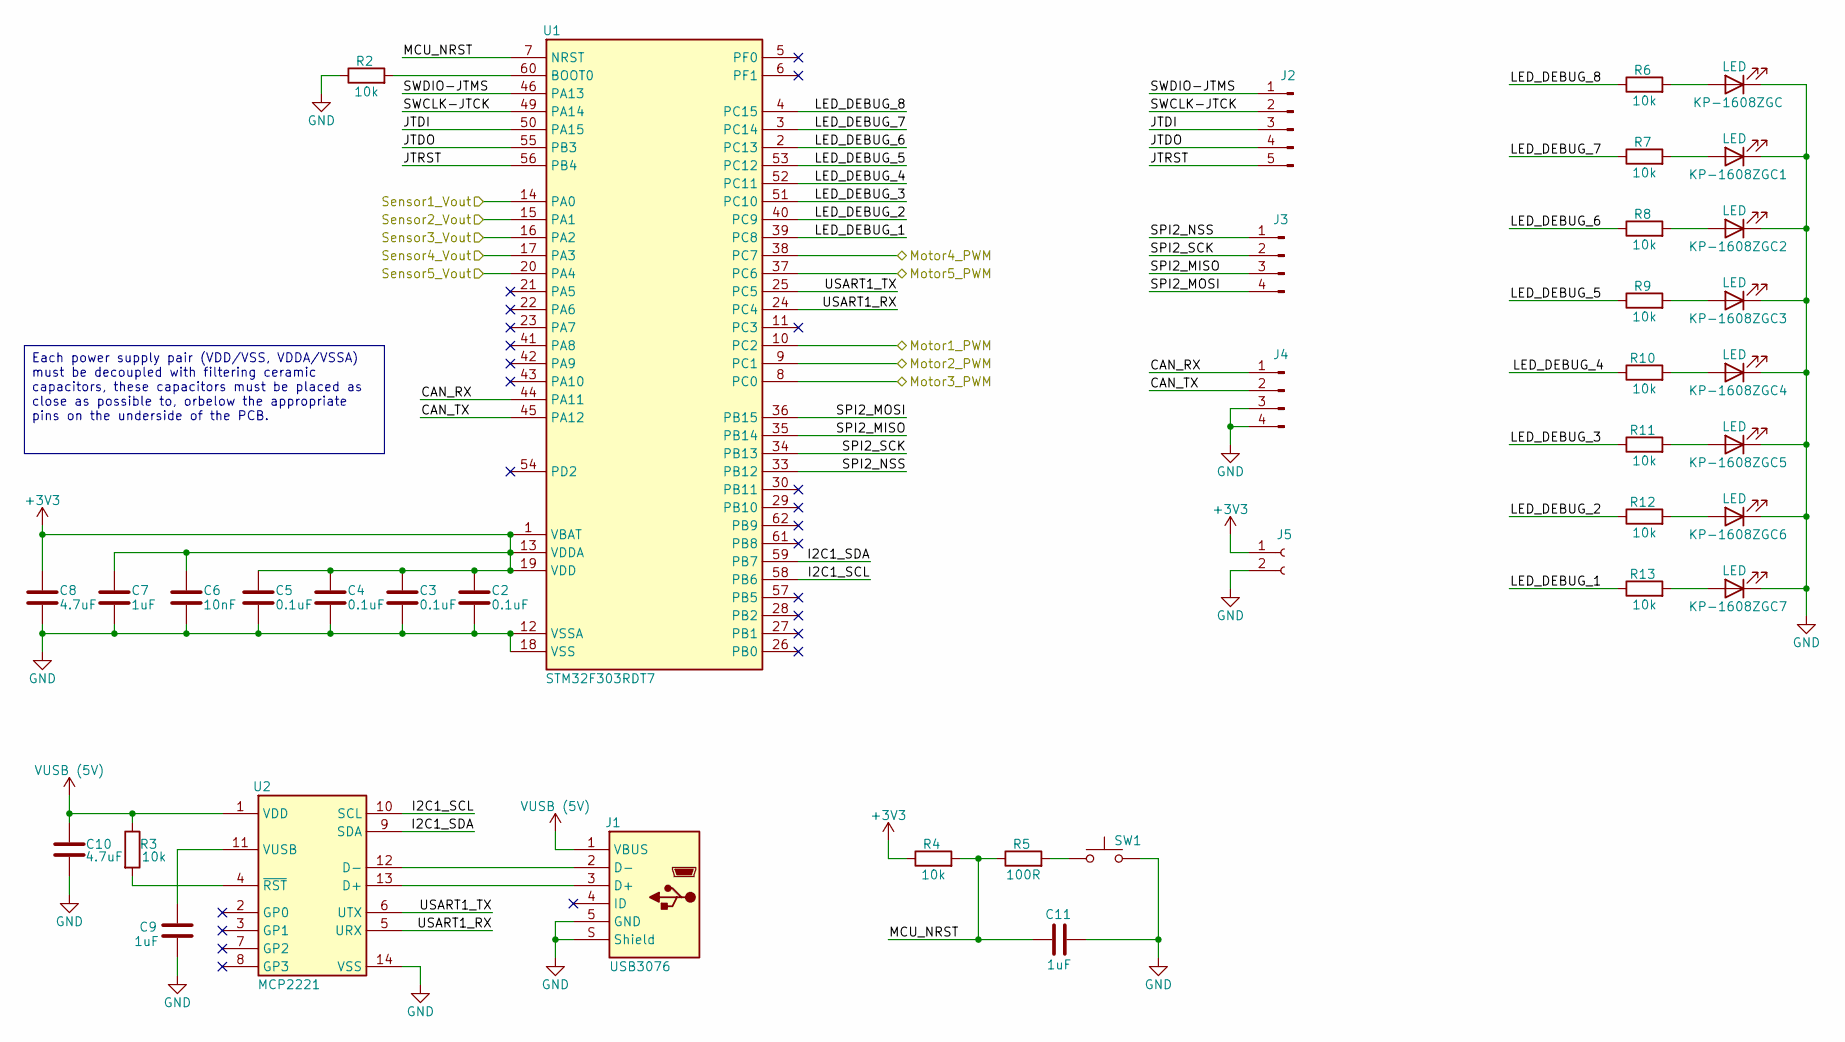
[picture p7: schematic mcu.kicad_sch]

Parts:
C2, C3, C4, C5: 0.1uF; C_0603_1608Metric
C6: 10nF; C_0603_1608Metric
C7, C9, C11: 1uF; C_0603_1608Metric
C8, C10: 4.7uF; C_0603_1608Metric
J1: USB3076; GCT_USB3076-XX-X_REVC5
J2: Conn_01x05_Pin
J3, J4: Conn_01x04_Pin
J5: Conn_01x02_Socket
KP-1608ZGC, KP-1608ZGC1, KP-1608ZGC2, KP-1608ZGC3, KP-1608ZGC4, KP-1608ZGC5, KP-1608ZGC6, KP-1608ZGC7: LED
R2, R3, R4, R6, R7, R8, R9, R10, R11, R12, R13: 10k; R_0603_1608Metric
R5: 100R; R_0603_1608Metric
SW1: SW_Push
U1: STM32F303RDT7; LQFP-64_10x10mm_P0.5mm
U2: MCP2221; SOIC-14_3.9x8.7mm_P1.27mm

Connections:
+3V3: C2.1, C3.1, C4.1, C5.1, C6.1, C7.1, C8.1, J5.1, R4.1, U1.1 (VBAT), U1.13 (VDDA), U1.19 (VDD), U1.32 (VDD), U1.48 (VDD), U1.64 (VDD)
CAN_RX: J4.1, U1.44 (PA11)
CAN_TX: J4.2, U1.45 (PA12)
GND: C2.2, C3.2, C4.2, C5.2, C6.2, C7.2, C8.2, C9.1, C10.1, C11.2, J1.5 (GND), J1.S (Shield), J4.3, J4.4, J5.2, KP-1608ZGC.1 (K), KP-1608ZGC1.1 (K), KP-1608ZGC2.1 (K), KP-1608ZGC3.1 (K), KP-1608ZGC4.1 (K), KP-1608ZGC5.1 (K), KP-1608ZGC6.1 (K), KP-1608ZGC7.1 (K), R2.1, SW1.2, U1.12 (VSSA), U1.18 (VSS), U1.31 (VSS), U1.47 (VSS), U1.63 (VSS), U2.14 (VSS)
I2C1_SCL: U1.58 (PB6), U2.10 (SCL)
I2C1_SDA: U1.59 (PB7), U2.9 (SDA)
JTDI: J2.3, U1.50 (PA15)
JTDO: J2.4, U1.55 (PB3)
JTRST: J2.5, U1.56 (PB4)
LED_DEBUG_1: R13.1, U1.39 (PC8)
LED_DEBUG_2: R12.1, U1.40 (PC9)
LED_DEBUG_3: R11.1, U1.51 (PC10)
LED_DEBUG_4: R10.1, U1.52 (PC11)
LED_DEBUG_5: R9.1, U1.53 (PC12)
LED_DEBUG_6: R8.1, U1.2 (PC13)
LED_DEBUG_7: R7.1, U1.3 (PC14)
LED_DEBUG_8: R6.1, U1.4 (PC15)
MCU_NRST: C11.1, R4.2, R5.1, U1.7 (NRST)
Motor1_PWM: U1.10 (PC2)
Motor2_PWM: U1.9 (PC1)
Motor3_PWM: U1.8 (PC0)
Motor4_PWM: U1.38 (PC7)
Motor5_PWM: U1.37 (PC6)
unnamed: C9.2, U2.11 (VUSB)
unnamed: J1.2 (D-), U2.12 (D-)
unnamed: J1.3 (D+), U2.13 (D+)
unnamed: KP-1608ZGC1.2 (A), R7.2
unnamed: KP-1608ZGC2.2 (A), R8.2
unnamed: KP-1608ZGC3.2 (A), R9.2
unnamed: KP-1608ZGC4.2 (A), R10.2
unnamed: KP-1608ZGC5.2 (A), R11.2
unnamed: KP-1608ZGC6.2 (A), R12.2
unnamed: KP-1608ZGC7.2 (A), R13.2
unnamed: KP-1608ZGC.2 (A), R6.2
unnamed: R2.2, U1.60 (BOOT0)
unnamed: R3.2, U2.4 (~RST)
unnamed: R5.2, SW1.1
SPI2_MISO: J3.3, U1.35 (PB14)
SPI2_MOSI: J3.4, U1.36 (PB15)
SPI2_NSS: J3.1, U1.33 (PB12)
SPI2_SCK: J3.2, U1.34 (PB13)
SWCLK-JTCK: J2.2, U1.49 (PA14)
SWDIO-JTMS: J2.1, U1.46 (PA13)
Sensor1_Vout: U1.14 (PA0)
Sensor2_Vout: U1.15 (PA1)
Sensor3_Vout: U1.16 (PA2)
Sensor4_Vout: U1.17 (PA3)
Sensor5_Vout: U1.20 (PA4)
USART1_RX: U1.24 (PC4), U2.5 (URX)
USART1_TX: U1.25 (PC5), U2.6 (UTX)
VUSB (5V): C10.2, J1.1 (VBUS), R3.1, U2.1 (VDD)

Notes on the sheet:
Each power supply pair (VDD/VSS, VDDA/VSSA) must be decoupled with filtering ceramic capacitors, these capacitors must be placed as close as possible to, orbelow the appropriate pins on the underside of the PCB.
