SemuBot/semubot-electronics/Kaur-thesis-2025-servo-arm/Servo-Controller-Firmware/Core/Src/main.c

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
/* Includes ------------------------------------------------------------------*/
#include "main.h"
#include "adc.h"
#include "dma.h"
#include "tim.h"
#include "usart.h"
#include "gpio.h"

/* USER CODE BEGIN Includes */

#include "pwm.h"
#include "adc_reading.h"
#include "uart_tr.h"

/* USER CODE END Includes */


void SystemClock_Config(void);
/**
  * @brief  The application entry point.
  * @retval int
  */
int main(void)
{

  /* MCU Configuration--------------------------------------------------------*/

  /* Reset of all peripherals, Initializes the Flash interface and the Systick. */
  HAL_Init();

  /* Configure the system clock */
  SystemClock_Config();

  /* Initialize all configured peripherals */
  MX_GPIO_Init();
  MX_DMA_Init();
  MX_ADC1_Init();
  MX_ADC2_Init();
  MX_TIM1_Init();
  MX_TIM2_Init();
  MX_TIM8_Init();
  MX_USART1_UART_Init();
  /* USER CODE BEGIN 2 */
  HAL_TIM_PWM_Start(&htim1, TIM_CHANNEL_1);
	HAL_TIM_PWM_Start(&htim1, TIM_CHANNEL_2);
	HAL_TIM_PWM_Start(&htim1, TIM_CHANNEL_3);
	HAL_TIM_PWM_Start(&htim8, TIM_CHANNEL_1);
	HAL_TIM_PWM_Start(&htim8, TIM_CHANNEL_2);

	HAL_TIM_Base_Start_IT(&htim2);

	HAL_ADC_Start_DMA(&hadc1, adc1_values, 4);
	HAL_ADC_Start_DMA(&hadc2, adc2_values, 1);

	PWM_var_init();
	//6 BYTES MUST BE SENT
	init_uart_rx_interrupt(32);

  /* USER CODE END 2 */

  /* Infinite loop */
  /* USER CODE BEGIN WHILE */
  while (1)
  {
	  HAL_GPIO_TogglePin(GPIOC, 0x0100);
	  HAL_Delay(1000);
    /* USER CODE END WHILE */

    /* USER CODE BEGIN 3 */
  }
  /* USER CODE END 3 */
}

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
