SemuBot/semubot-electronics/Kaur-thesis-2025-servo-arm/Servo-Controller-Firmware/Arm_Servo_Controller_board.ioc

Mcu.UserName=STM32F303RDTx
PA0.Signal=ADC1_IN1
PA1.Signal=ADC1_IN2
PA13.Signal=SYS_JTMS-SWDIO
PA14.Signal=SYS_JTCK-SWCLK
PA15.Signal=SYS_JTDI
PA2.Signal=ADC1_IN3
PA3.Signal=ADC1_IN4
PA4.Signal=ADC2_IN1
PB3.Signal=SYS_JTDO-TRACESWO
PB4.Signal=SYS_NJTRST
PC0.Signal=S_TIM1_CH1
PC1.Signal=S_TIM1_CH2
PC10.Signal=GPIO_Output
PC11.Signal=GPIO_Output
PC12.Signal=GPIO_Output
PC13.Signal=GPIO_Output
PC14-OSC32_IN.Signal=GPIO_Output
PC15-OSC32_OUT.Signal=GPIO_Output
PC2.Signal=S_TIM1_CH3
PC4.Signal=USART1_TX
PC5.Signal=USART1_RX
PC6.Signal=S_TIM8_CH1
PC7.Signal=S_TIM8_CH2
PC8.Signal=GPIO_Output
PC9.Signal=GPIO_Output
