SemuBot/semubot-electronics/(commit log)

2026-01-28 Added SPI and CAN support
2026-01-28 Wheelbase development and repo cleanup
    [Driver.kicad_sch, SemuBot-electronics-mainboard.kicad_pcb, SemuBot-electronics-mainboard.kicad_sch, Wheelbase.kicad_pcb, Wheelbase.kicad_sch, bom.csv, designators.csv, positions.csv]
2026-02-02 Current sensing
    [Driver.kicad_sch, Wheelbase.kicad_pcb, Wheelbase.kicad_sch]
2026-02-04 Gerber files
2026-02-04 Current sensing, + changing encoder pins
    [Driver.kicad_sch, Wheelbase.kicad_pcb, Wheelbase.kicad_sch, bom.csv, designators.csv, positions.csv]
2026-03-23 Encoder fix
    [Driver.kicad_sch, Wheelbase.kicad_pcb, Wheelbase.kicad_sch, bom.csv, designators.csv, positions.csv]
2026-03-23 Removed HW version, added it into a branch
    [Driver.kicad_sch, Wheelbase.kicad_pcb, Wheelbase.kicad_sch, bom.csv, connectors.kicad_sch, designators.csv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]
2026-03-23 Updated mosfet symbols and organization
    [Driver.kicad_sch, Wheelbase.kicad_sch]
2026-03-30 Fixing schematics
    [Driver.kicad_sch, Wheelbase.kicad_sch]
2026-04-14 Re organizing, adding .pdf
    [Driver.kicad_sch, Wheelbase.kicad_sch]
2026-08-12 New 4-layer board
    [Driver.kicad_sch, Wheelbase.kicad_pcb, Wheelbase.kicad_sch, bom.csv, designators.csv, positions.csv]
2026-09-03 Cleaning library
    [Wheelbase.kicad_pcb]
2026-09-21 adding the powerboard files
    [HotSwap.SchDoc, PCB_S.PcbDoc, VoltageDivision.SchDoc]
2026-10-13 Schematic and pcb fix
2026-10-28 imported servo arm and powerboard projects
2026-10-28 moved wheelbase libraries to external lib
2026-10-28 moved wheelbase lib to shared lib
