SemuBot/semubot-electronics/(notices)

Notices in the files:
Kaur-thesis-2025-servo-arm/Servo-Controller-Firmware/Core/Src/gpio.c:
Copyright (c) 2025 STMicroelectronics.
All rights reserved.
This software is licensed under terms that can be found in the LICENSE file
